clementgaudet1002-hub/Enceinte-Bluetooth-TPA3110D2/assets/Ampli_KiCad.png

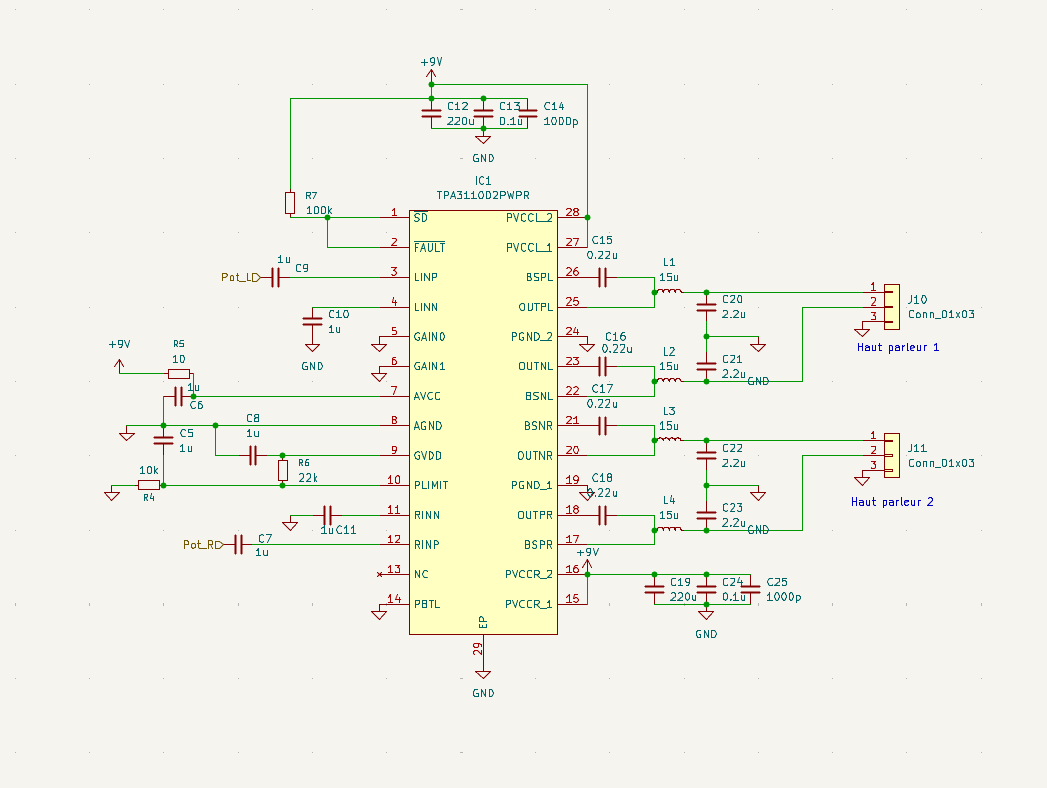
assets/Ampli_KiCad.png
