clementgaudet1002-hub/Enceinte-Bluetooth-TPA3110D2/assets/Filtre_4_ohm.png

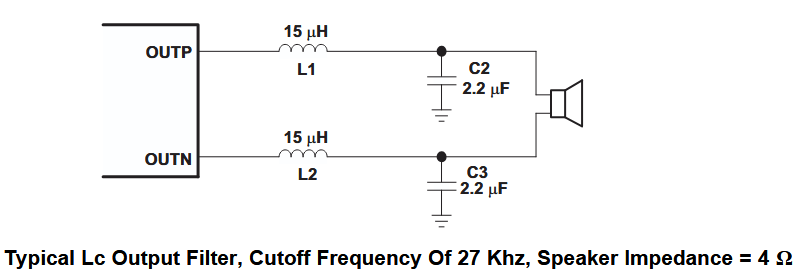
assets/Filtre_4_ohm.png
