clementgaudet1002-hub/Enceinte-Bluetooth-TPA3110D2/assets/KiCad_elec.png

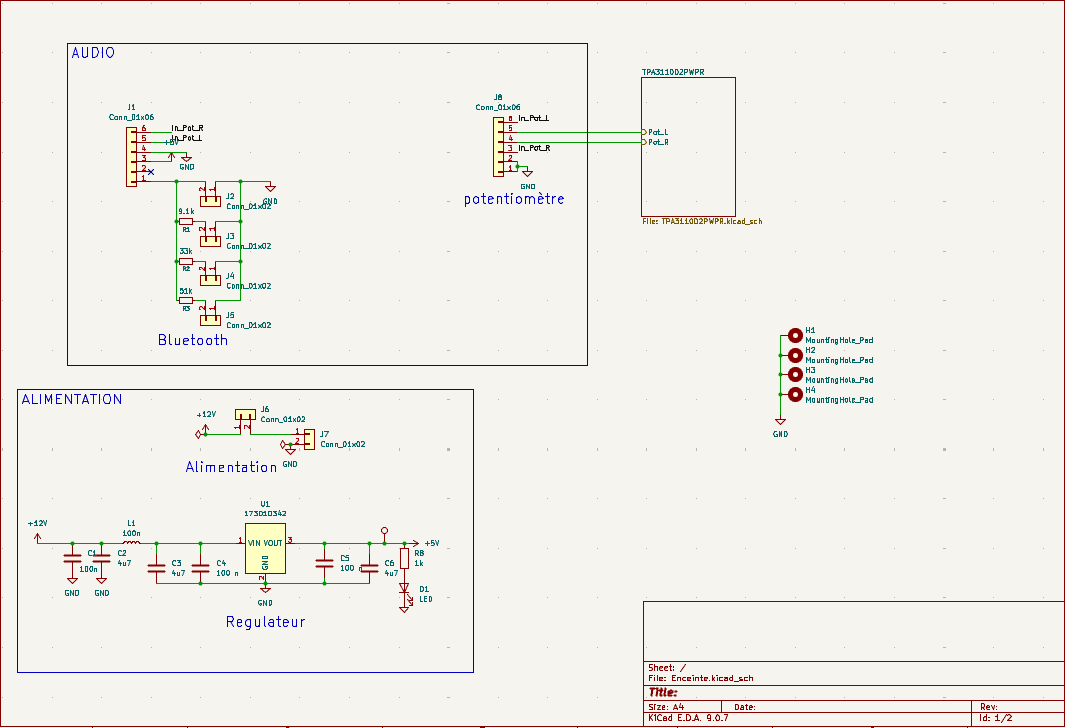
assets/KiCad_elec.png
