clementgaudet1002-hub/Enceinte-Bluetooth-TPA3110D2/assets/Shema_Principe.png

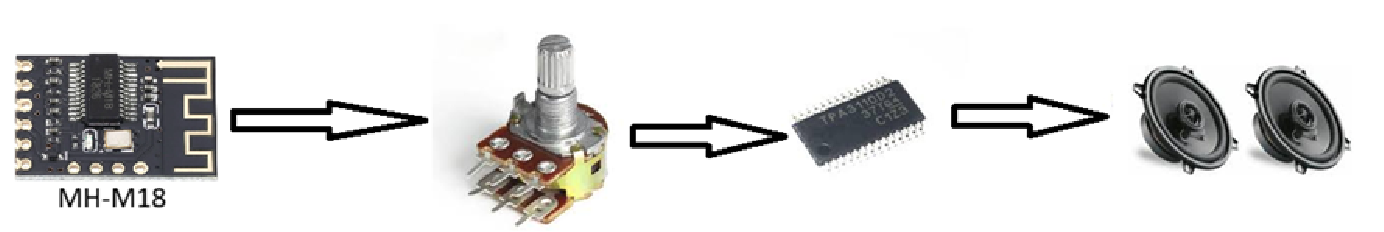
assets/Shema_Principe.png
