clementgaudet1002-hub/Enceinte-Bluetooth-TPA3110D2/hardware/librairies/CWF1612A-R10K/3D/CWF1612A-R10K.stp

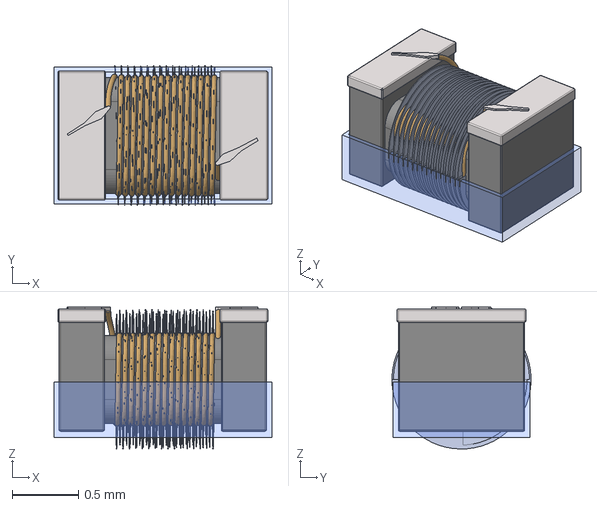
[picture p15: CAD file, 2026-11-07]
hardware/librairies/CWF1612A-R10K/3D/CWF1612A-R10K.stp
1.64 x 1.05 x 1.07 mm
