clementgaudet1002-hub/Enceinte-Bluetooth-TPA3110D2/hardware/librairies/L7805/L7805.step

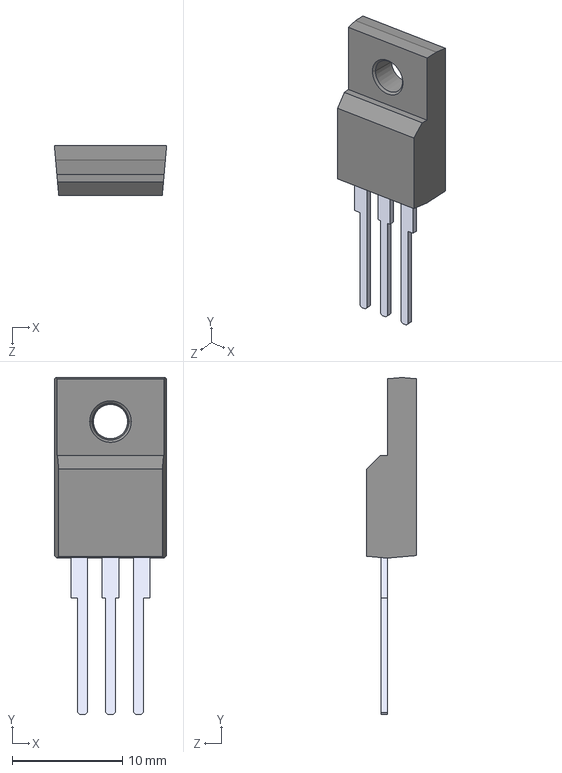
[picture p16: CAD file, 2026-11-07]
hardware/librairies/L7805/L7805.step
10.2 x 30.6 x 4.50 mm
