clementgaudet1002-hub/Enceinte-Bluetooth-TPA3110D2/hardware/librairies/SRN5040-150M/3D/SRN5040-150M.stp

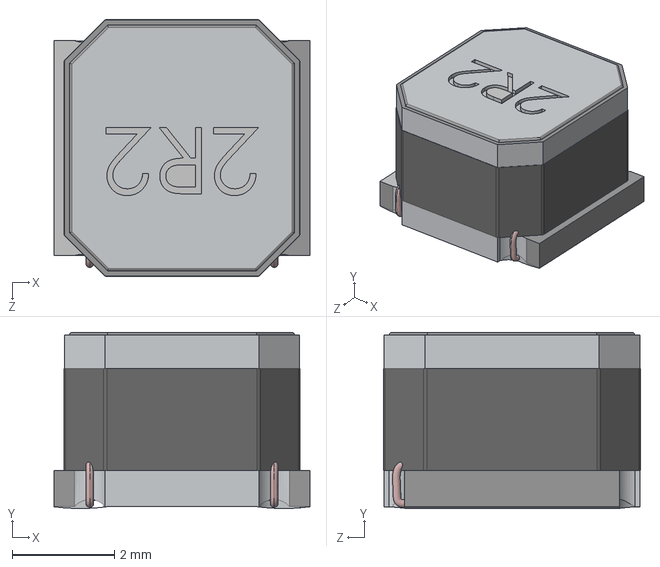
[picture p17: CAD file, 2026-11-07]
hardware/librairies/SRN5040-150M/3D/SRN5040-150M.stp
5.00 x 3.44 x 5.02 mm
