clementgaudet1002-hub/Enceinte-Bluetooth-TPA3110D2/hardware/librairies/TB6612FNG,C,8,EL/3D/TB6612FNG,C,8,EL.stp

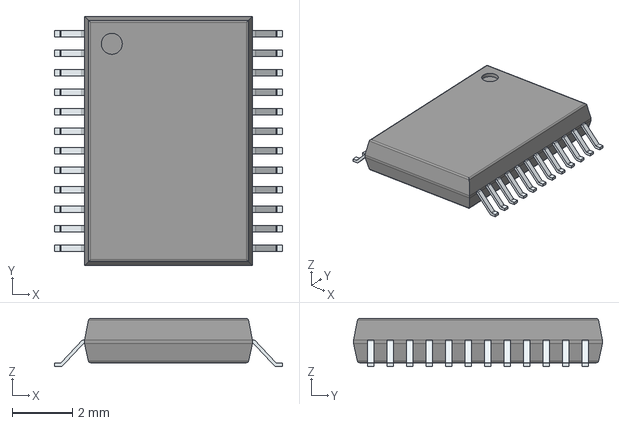
[picture p18: CAD file, 2026-11-07]
hardware/librairies/TB6612FNG,C,8,EL/3D/TB6612FNG,C,8,EL.stp
7.60 x 8.30 x 1.60 mm
PinsArrayLR
