clementgaudet1002-hub/Enceinte-Bluetooth-TPA3110D2/hardware/librairies/TPA3110D2PWPR/3D/TPA3110D2PWPR.stp

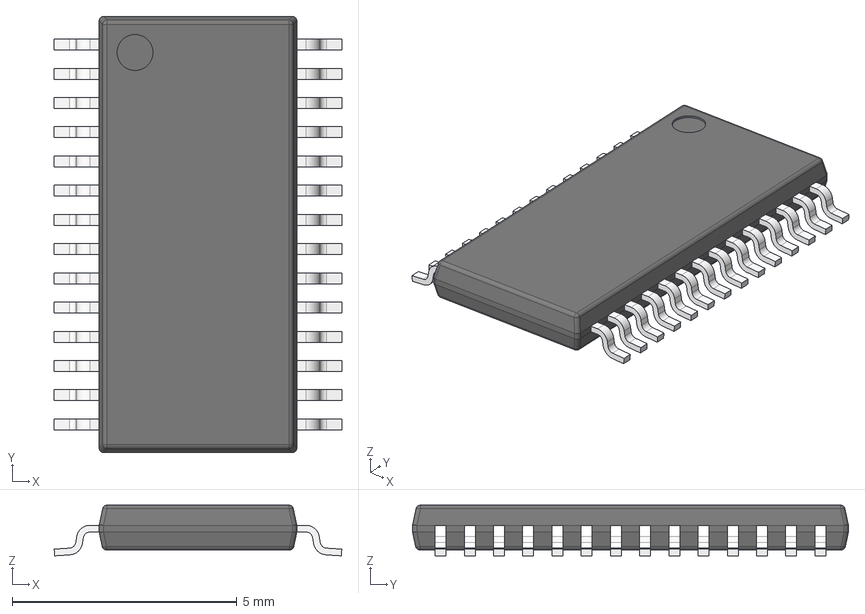
[picture p19: CAD file, 2026-11-07]
hardware/librairies/TPA3110D2PWPR/3D/TPA3110D2PWPR.stp
6.40 x 9.70 x 1.13 mm
BODY-TSSOP
LEAD-TSSOP x 28
DAP
