clementgaudet1002-hub/Enceinte-Bluetooth-TPA3110D2/mechanical/solidworks/moule.SLDPRT

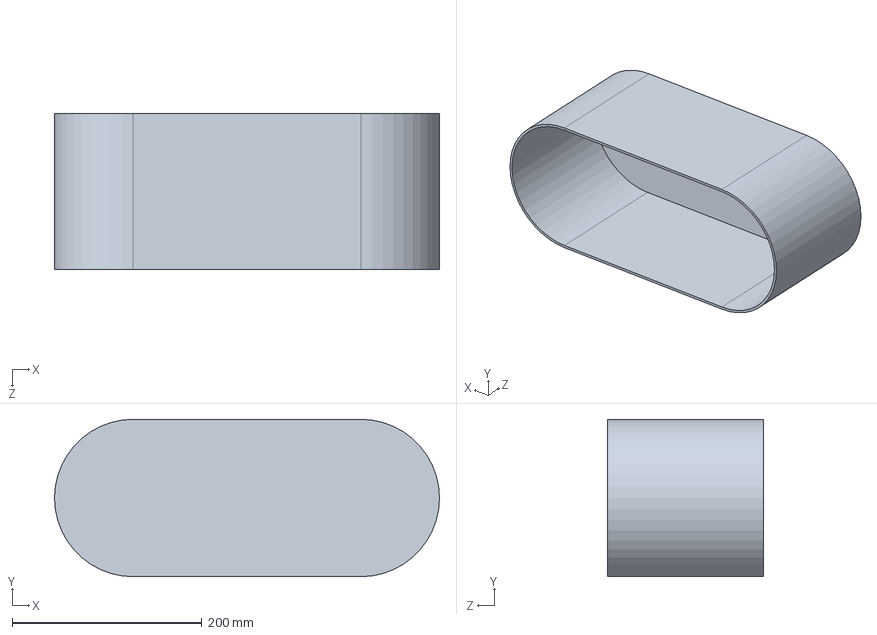
[picture p20: CAD file, 2026-11-07]
mechanical/solidworks/moule.SLDPRT
406.0 x 166.0 x 165.0 mm
