clementgaudet1002-hub/Enceinte-Bluetooth-TPA3110D2/mechanical/solidworks/face_arriere.SLDPRT

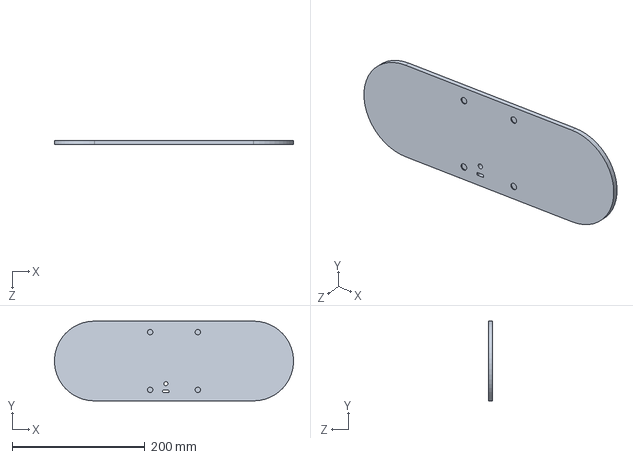
[picture p22: CAD file, 2026-11-07]
mechanical/solidworks/face_arriere.SLDPRT
359.7 x 120.0 x 6.00 mm
