clementgaudet1002-hub/Enceinte-Bluetooth-TPA3110D2/mechanical/solidworks/chariot.SLDPRT

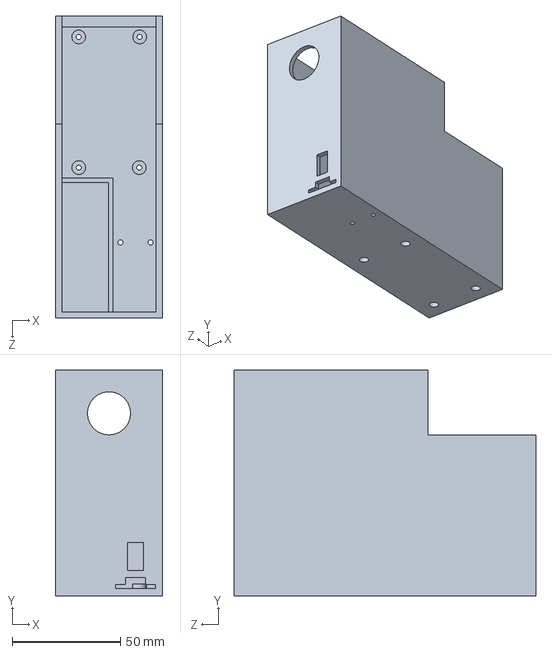
[picture p23: CAD file, 2026-11-07]
mechanical/solidworks/chariot.SLDPRT
49.5 x 104.5 x 139.8 mm
