clementgaudet1002-hub/Enceinte-Bluetooth-TPA3110D2/mechanical/solidworks/Corps_plastique.SLDPRT

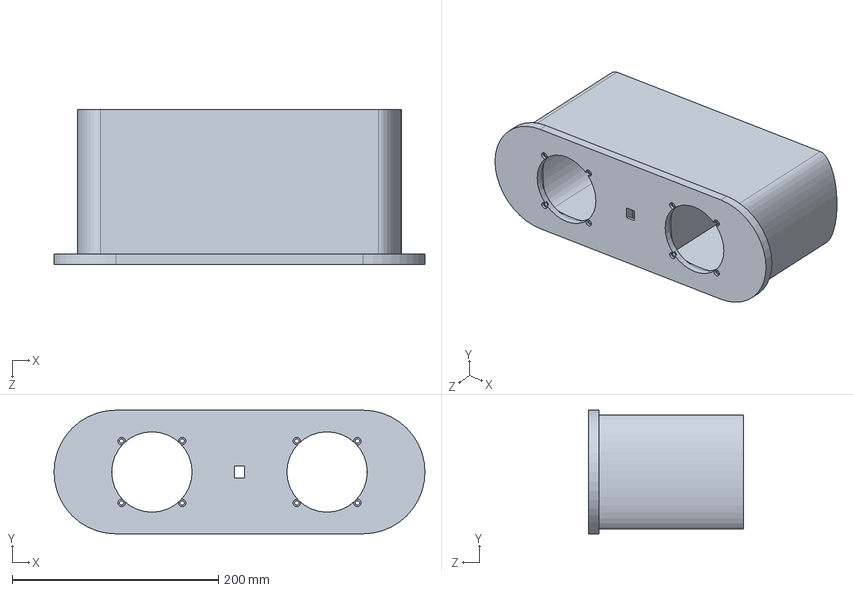
[picture p24: CAD file, 2026-11-07]
mechanical/solidworks/Corps_plastique.SLDPRT
360.0 x 120.0 x 150.0 mm
