clementgaudet1002-hub/Enceinte-Bluetooth-TPA3110D2/hardware/librairies/buck/premier/MP008288/3D/MP008288.stp

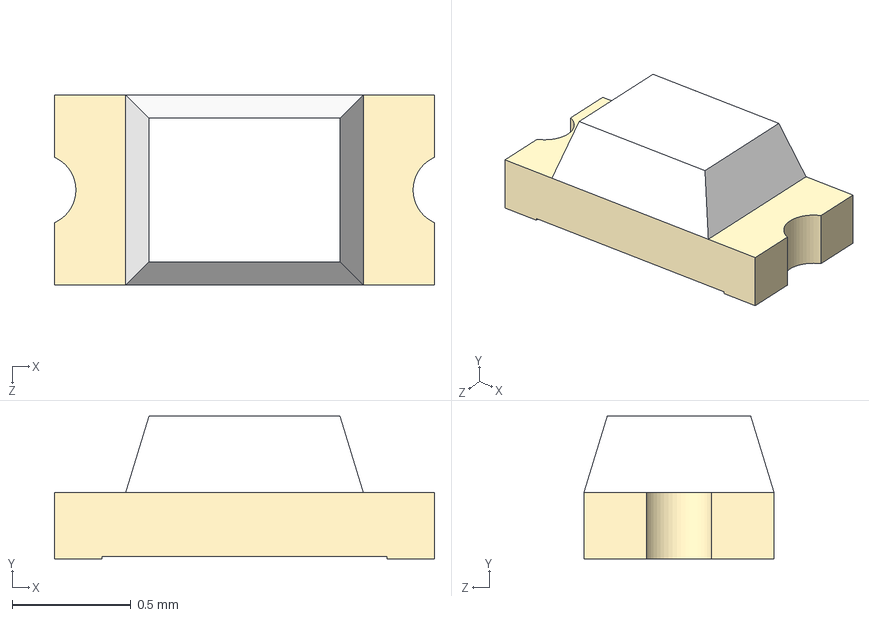
[picture p25: CAD file, 2026-11-07]
hardware/librairies/buck/premier/MP008288/3D/MP008288.stp
1.60 x 0.6 x 0.8 mm
