clementgaudet1002-hub/Enceinte-Bluetooth-TPA3110D2/mechanical/solidworks/Assemblage.SLDASM

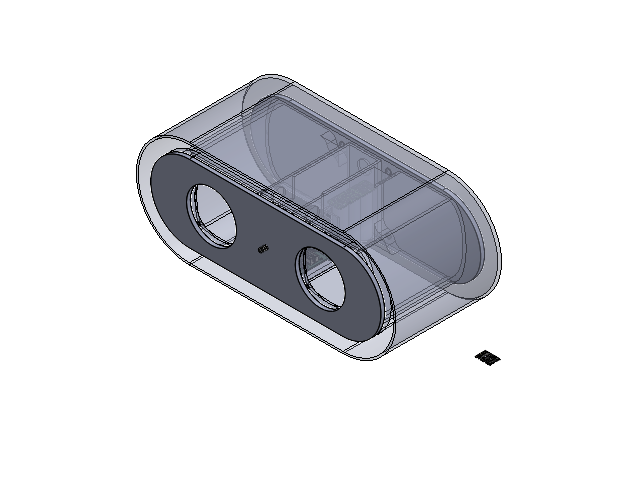
[picture p26: CAD file, 2026-11-07]
mechanical/solidworks/Assemblage.SLDASM
Corps_plastique
chariot
Board^3s_charger
RES_SMD_1206^3s_charger x 2
CAP_SMD_0805_H0.9^3s_charger x 3
CAP_SMD_1206_H1.4^3s_charger x 3
RES_SMD_0805^3s_charger x 2
LED_0805_Green^3s_charger
LED_0805_Red^3s_charger
SO8^3s_charger x 2
Diode_DO214AA(SMB)^3s_charger
Inductor_SMD_AMPLF_0630^3s_charger
USB_Type-C_Female_6pin^3s_charger
R_0805_001.step
R_0805_002.step
R_0805_003.step
R_0805_004.step
R_0805_005.step
R_0805_006.step
R_0805_007.step
R_0805_008.step
R_0805_009.step
R_0805_010.step
R_0805_011.step
R_0805_012.step
R_0805_013.step
R_0805_014.step
R_0805_015.step
R_0805_016.step
R_0805_017.step
R_0805_018.step
R_0805_019.step
R_0805_020.step
R_0805_021.step
R_0805_022.step
R_0805_023.step
R_0805_024.step
C_0805_001.step
C_0805_002.step
C_0805_003.step
C_0805_004.step
C_0805_005.step
SOT-23-6_001.step
SOT-23-6_002.step
SOT-23-6_003.step
SOT-23-3_001.step
SOT-23-3_002.step
SOT-23-3_003.step
SOT-23-3_004.step
SOT-23-3_005.step
SOT-23-3_006.step
SOT-23-3_007.step
SOT-23-3_008.step
SOT-23-3_009.step
COMPOUND.step
COMPOUND001.step
COMPOUND002.step
COMPOUND003.step
COMPOUND004.step
COMPOUND007.step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
