clementgaudet1002-hub/Enceinte-Bluetooth-TPA3110D2/(list of files, cad)

Other CAD files:
hardware/librairies/CWF1612A-R10K/Allegro/cwf1612a100j.psm
hardware/librairies/CWF1612A-R10K/DEHDL/cwf1612a_r10k/chips/chips.prt
hardware/librairies/SRN5040-150M/Allegro/srn5040.psm
hardware/librairies/SRN5040-150M/DEHDL/srn5040_150m/chips/chips.prt
hardware/librairies/TB6612FNG,C,8,EL/Allegro/sop65p760x160-24n.psm
hardware/librairies/TB6612FNG,C,8,EL/DEHDL/tb6612fng_c_8_el/chips/chips.prt
hardware/librairies/TPA3110D2PWPR/Allegro/sop65p640x120-29n.psm
hardware/librairies/TPA3110D2PWPR/DEHDL/tpa3110d2pwpr/chips/chips.prt
hardware/librairies/buck/premier/MP008288/Allegro/ledc1608x60n.psm
hardware/librairies/buck/premier/MP008288/DEHDL/mp008288/chips/chips.prt
