clementgaudet1002-hub/Enceinte-Bluetooth-TPA3110D2/(list of files, drawings)

Other design files:
hardware/librairies/buck/premier/MP008288/Altium/LEDC1608X60N.PcbLib
hardware/librairies/buck/premier/MP008288/Altium/MP008288.SchLib
hardware/librairies/CWF1612A-R10K/Altium/CWF1612A100J.PcbLib
hardware/librairies/CWF1612A-R10K/Altium/CWF1612A-R10K.SchLib
hardware/librairies/TB6612FNG,C,8,EL/Altium/SOP65P760X160-24N.PcbLib
hardware/librairies/TB6612FNG,C,8,EL/Altium/TB6612FNG_C_8_EL.SchLib
hardware/librairies/TPA3110D2PWPR/Altium/SOP65P640X120-29N.PcbLib
hardware/librairies/TPA3110D2PWPR/Altium/TPA3110D2PWPR.SchLib
